Lucaseduardo1204/Chaveiro_robo/case/case_frente_ps4.stl

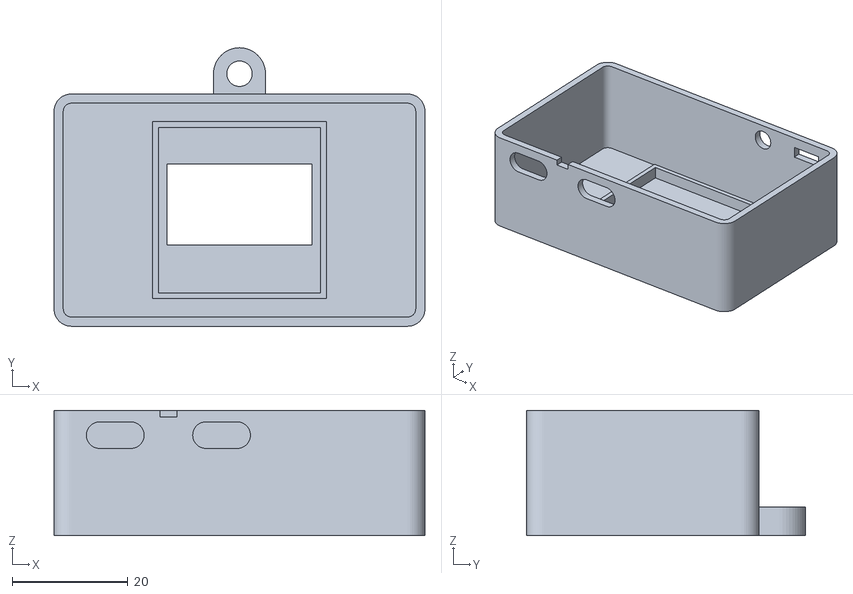
[picture p2: CAD file, 2026-10-25]
case/case_frente_ps4.stl
64.2 x 48.2 x 21.7
