Lucaseduardo1204/Chaveiro_robo/case/case_tampa_ps4.stl

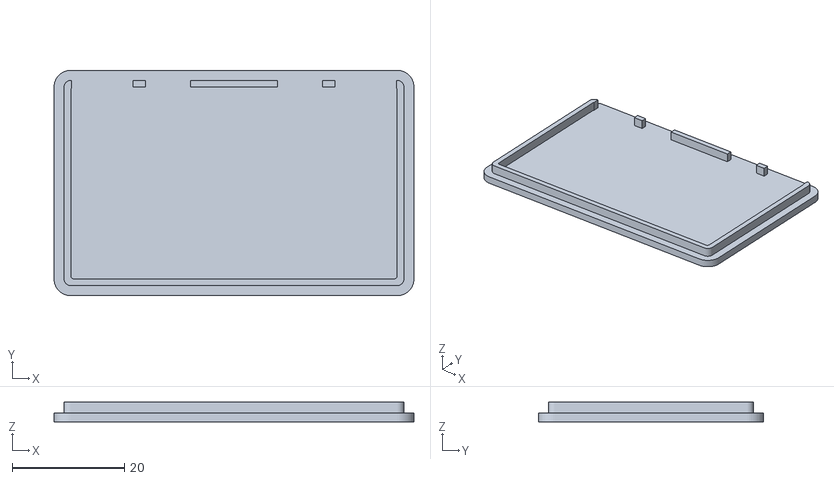
[picture p3: CAD file, 2026-10-25]
case/case_tampa_ps4.stl
64.2 x 40.2 x 3.55
