Lucaseduardo1204/Chaveiro_robo/case/case_frente_fone.stl

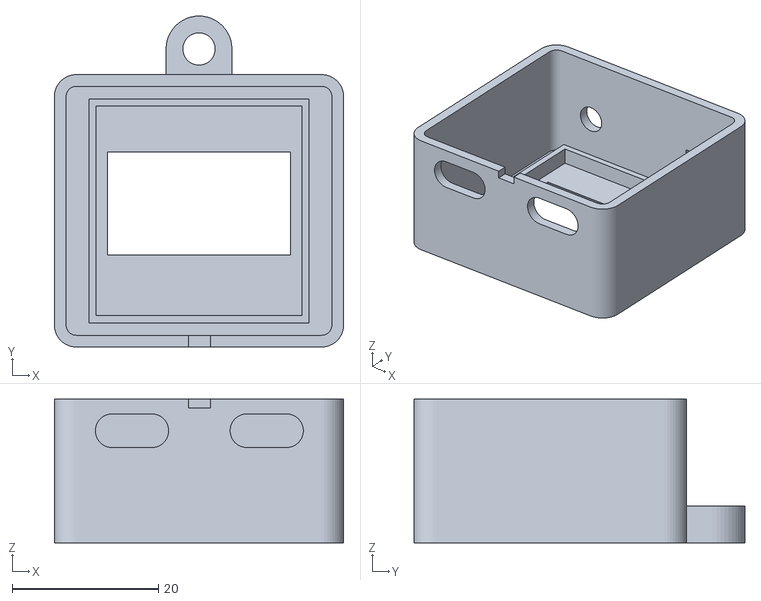
[picture p4: CAD file, 2026-10-25]
case/case_frente_fone.stl
39.5 x 45.2 x 19.6
