Lucaseduardo1204/Chaveiro_robo/case/case_tampa_fone.stl

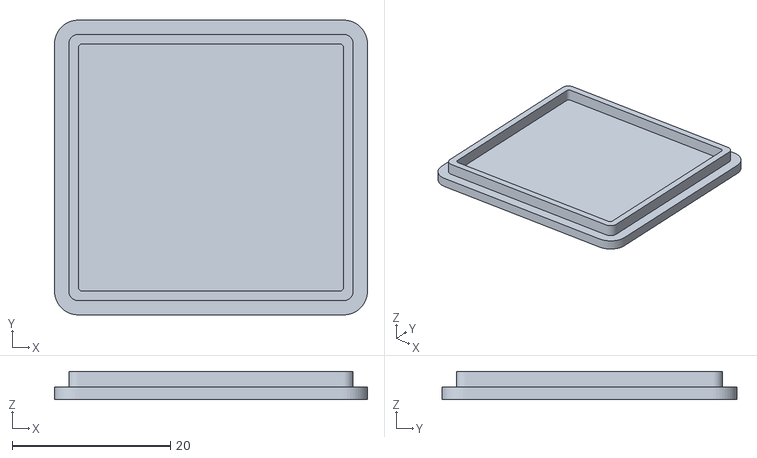
[picture p5: CAD file, 2026-10-25]
case/case_tampa_fone.stl
39.5 x 37.2 x 3.55
